Daksh-Saksena/Syringe_pump/Firmware/README.md

Just upload this c++ code to ur arduino, based on how u did wiring change values and syringe dimensions!
Libraries -> AccelStepper by Mike McCauley and LiquidCrystal_I2C by frank de barbadar
