Daksh-Saksena/Syringe_pump/BOM.csv

Component | info | Quantity | (WE ALR HAD EVERYTHING ON HAND SO FREE FOR US) Price (₹) | Total Price ₹ | Link
3D Printed Parts | not a lot of filament | 1 | 0 | 0
Stepper Motor + Driver | 28BYJ48 5V stepper motor with ULN2003 driver board | 1 | 100 ($1.07) | 100 ($1.07) | https://robocraze.com/products/5v-stepper-motor?variant=40193680507033&country=IN&currency=INR
T8 Lead Screw | 8mm diameter 2mm pitch 4 start lead screw 400mm | 1 | 270 ($2.89) | 370 ($3.96) | https://robocraze.com/products/330mm-trapezoidal-4-start-lead-screw-8mm-thread-2mm-pitch-lead-screw-with-copper-nut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
LCD Display | JHD162A or simmilar 16x2 LCD with I2C backpack | 1 | 180 ($1.92) | 550 ($5.88) | https://robocraze.com/products/16x2-lcd-blue-with-i2c-interface?variant=40192696352921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
Arduino Uno | UNO R3 | 1 | 250 ($2.67) | 800 ($8.55) | https://robocraze.com/products/uno-r3-ch340g-development-board-with-micro-usb-port-compatible-with-arduino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>+35%25+%7C+18%2F05&utm_source=googleads&utm_medium=ppc&utm_campaign=21311497592&utm_content=_&utm_term=&campaignid=21311497592&adgroupid=&campaign=21311497592&gad_source=1&gad_campaignid=21305067285&gclid=Cj0KCQiA-8XXBhDaARIsADnEOrBsIizijx0sK46hOWDELl4MPX69idMw5xVAgCAuAOp7wk0paEnCg-oaAg_uEALw_wcB
TOTAL |  |  |  | 800 ($8.55)
