Daksh-Saksena/Syringe_pump/(list of files, cad)

Other CAD files:
CAD/box.f3d
CAD/fluid_loader_v4,9.f3d
