Daksh-Saksena/Syringe_pump/(commit log)

2026-11-11 adding cad
    [box.f3d]
2026-11-12 uploading cad
    [fluid_loader_v4,9.f3d]
